Gpauline03/Glovetooth/Rapports séances/Gosselin_R7.pdf

Rapport du vendredi 21 février 2020

Lors de cette séance j’ai fini la conception du gant. J’ai finalisé les branchements du module Bluetooth HC06. J’ai scotché tous les endroits où il y avait des soudures pour éviter les courts-circuits. J’ai également scotché les câbles : en effet j’avais utilisé des câbles longs pour éviter que lorsque l’on utilise le gant cela ne tire trop sur les branchements. Mais avec les différentes soudures en partant de celle au niveau du cuivre à celle multiple au niveau du branchement 5V, la longueur était trop importante et les câbles s’emmêlaient. C’est pourquoi j’ai scotché les câbles pour les rendre plus court. J’ai aussi immobilisé les branchements des câbles à la carte Arduino UNO.

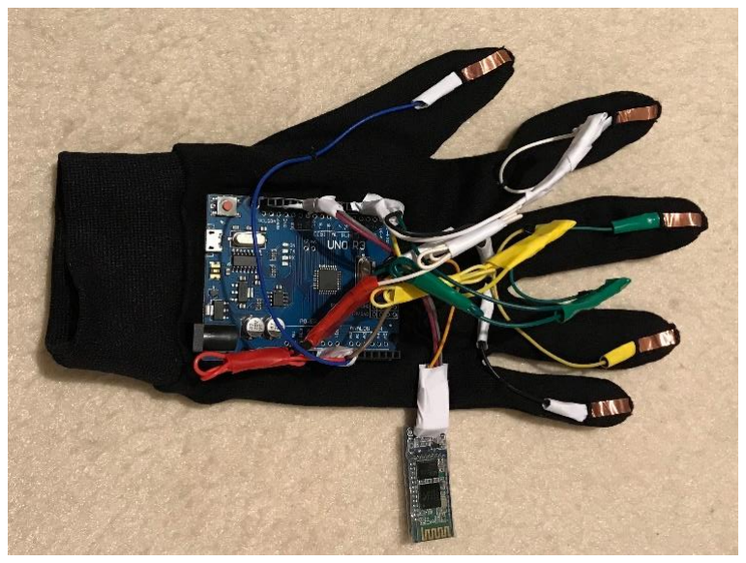
[picture p1: figure]

De plus j’ai complété le planning final du projet.

Dans la suite de ce projet je vais aider Mathilde dans ces recherches pour la réalisation de l’application sur téléphone.
