Gpauline03/Glovetooth/Rapports séances/Vangeluwe_R7.pdf

## Rapport de la séance du 21 février 2020

Lors de cette séance je me suis encore renseignée sur le logiciel Android Studio. Je suis tombée sur le site d’une personne ayant utilisé Android Studio avec de l’Arduino. J’ai donc pu lire et comprendre son code pour voir comment la connexion était faite de l’Arduino à l’application. J’ai donc commencé à coder l’application.

Pendant la semaine de vacances je continuerai à coder l’application.
