Gpauline03/Glovetooth/Rapports séances/Vangeluwe_R8.pdf

## Rapport de la séance du 6 mars 2020

Lors de cette séance j’ai continué à travailler sur l’application à l’aide d’Android Studio.
