Gpauline03/Glovetooth/Rapports séances/Gosselin_R8.pdf

### Rapport de séance du vendredi 6 mars 2020

Lors de cette séance je n’avais plus beaucoup de chose à faire sur le projet lui-même. J’ai donc essayé un peu d’aider Mathilde en réalisant quelques recherches sur Android Studio.

Puis j’ai réalisé le planning final sur Excel afin de pouvoir le comparer avec l’initial lors de notre rapport de projet. Enfin j’ai démarré la préparation de l’oral de la semaine prochaine.
