Gpauline03/Glovetooth/Rapports séances/Vangeluwe_R6.pdf

## Rapport de la séance du 14 février 2020

J’ai complété les branchements du gant et vérifié qu’il fonctionnait bien. Pour cela je l’ai utilisé avec le programme permettant de contrôler le son sur l’ordinateur. J’ai d’abord rencontré un problème lié au programme mais j’ai réussi à le résoudre et le gant fonctionnait comme on le voulait en mettant les doigts en contact.

J’ai ensuite continué à regarder des vidéos sur le fonctionnement d’Android Studio et j’ai continué à prendre en main le logiciel. Je suis également allée vérifier que le logiciel était compatible avec le Bluetooth et d’après des commandes que j’ai trouvé il devrait l’être. Il me reste maintenant à finir de me renseigner sur le logiciel et enfin commencer l’application.
