Gpauline03/Glovetooth/Rapports séances/Gosselin_R6.pdf

### Rapport de séance du vendredi 14 février 2020

Lors de cette séance je me suis consacrée entièrement à la réalisation du gant.

En effet après avoir collé les bandes de cuivre et soudé les fils, les bandes de cuivre ne collaient plus au bout des doigts ; j’ai donc dû les coudre au gant. De plus il y a beaucoup de branchements au niveau de la main et de la carte Arduino. C’est pourquoi j’ai cousu de petits anneaux sur le gant pour guider les fils et éviter qu’ils s’emmêlent.

Enfin j’ai commencé à scotcher les fils et les soudures que j’avais réalisé pour éviter des courtscircuits, et pour que les branchements ne se défacent pas.
