Gpauline03/Glovetooth/Rapports séances/Vangeluwe_R5.pdf

## Rapport de la séance du 7 février 2020

Lors de cette séance j’ai fait des recherches à propos de l’application à réaliser. J’ai découvert Android Studio qui permet de faire des applications en codant en Java et qui permet de réaliser plus de fonctionnalités. J’ai également découvert qu’il existait des méthodes Java permettant de contrôler le volume sur Android. J’ai alors pris la décision d’abandonner la réalisation de l’application sur MIT App Inventor car même si l’utilisation est plus simple, elle ne correspondait pas tout à fait à ce que nous voulions réaliser. J’ai donc passé une grande partie de la séance à installer le logiciel Android Studio, à le tester et à regarder des tutoriels pour comprendre comment il fonctionne.
