Gpauline03/Glovetooth/Rapports séances/Vangeluwe_R4.pdf

## Rapport de la séance du 17 janvier 2020

Pendant cette séance j’ai continué à chercher comment accéder au son du téléphone. J’ai réalisé qu’il fallait surement que je me penche sur l’API Android pour cela et donc utiliser un autre langage informatique. Avec Pauline nous avons aussi décidé de commencer à monter le gant directement et nous avons décidé de coudre la carte directement sur le gant et de coller du scotch double face sur les doigts pour fixer le cuivre. Avant de coller le cuivre au gant nous allons le souder aux fils.

Nous avons ensuite décidé que nous allions d’abord nous concentrer sur la gestion du son à partir de l’application MIT App Inventor que nous allons créer. J’ai donc commencé à créer cette application et pour le moment nous pouvons connecter un module Bluetooth dessus. Je vais ensuite devoir ajouter une musique dessus et essayer de gérer la fonction Play/Pause.

Une fois que nous aurons réussi à gérer toutes ces fonctionnalités sur l’application, nous tenterons la même chose mais sur le téléphone directement.
