Gpauline03/Glovetooth/Rapports séances/Vangeluwe_R1.pdf

## Rapport de la séance du 13 décembre 2019

Lors de cette séance nous avons commencé à nous renseigner sur la manière dont nous allions connecter le gant à notre téléphone. Nous avons découvert qu’il allait falloir créer une application à l’aide de MIT App Inventor. Pendant le reste de la séance je me suis donc renseignée sur comment fonctionnait cette plateforme, et plus particulièrement comment s’en servir avec le Bluetooth. J’ai ensuite cherché un moyen de relier l’application et le son du téléphone afin de gérer les musiques et le volume. Mais je n’ai pas encore trouvé de moyen pour le faire.

Je vais donc devoir me pencher sur cette question lors de la semaine suivante. La semaine prochaine je vais également devoir commencer l’application et comprendre comment démarrer ou arrêter une musique avec. Une autre question sur laquelle je vais devoir me pencher est : est-il possible de déclencher un bouton sur l’application sans cliquer directement sur l’écran ? Car en effet nous devons déclencher la musique en mettant les doigts du gant en contact et non en appuyant sur le bouton.
